JustinOng/bldctest2/README.md

PCB with STM32F103 + MP6540 to experiment with driving a small brushless gimbal motor

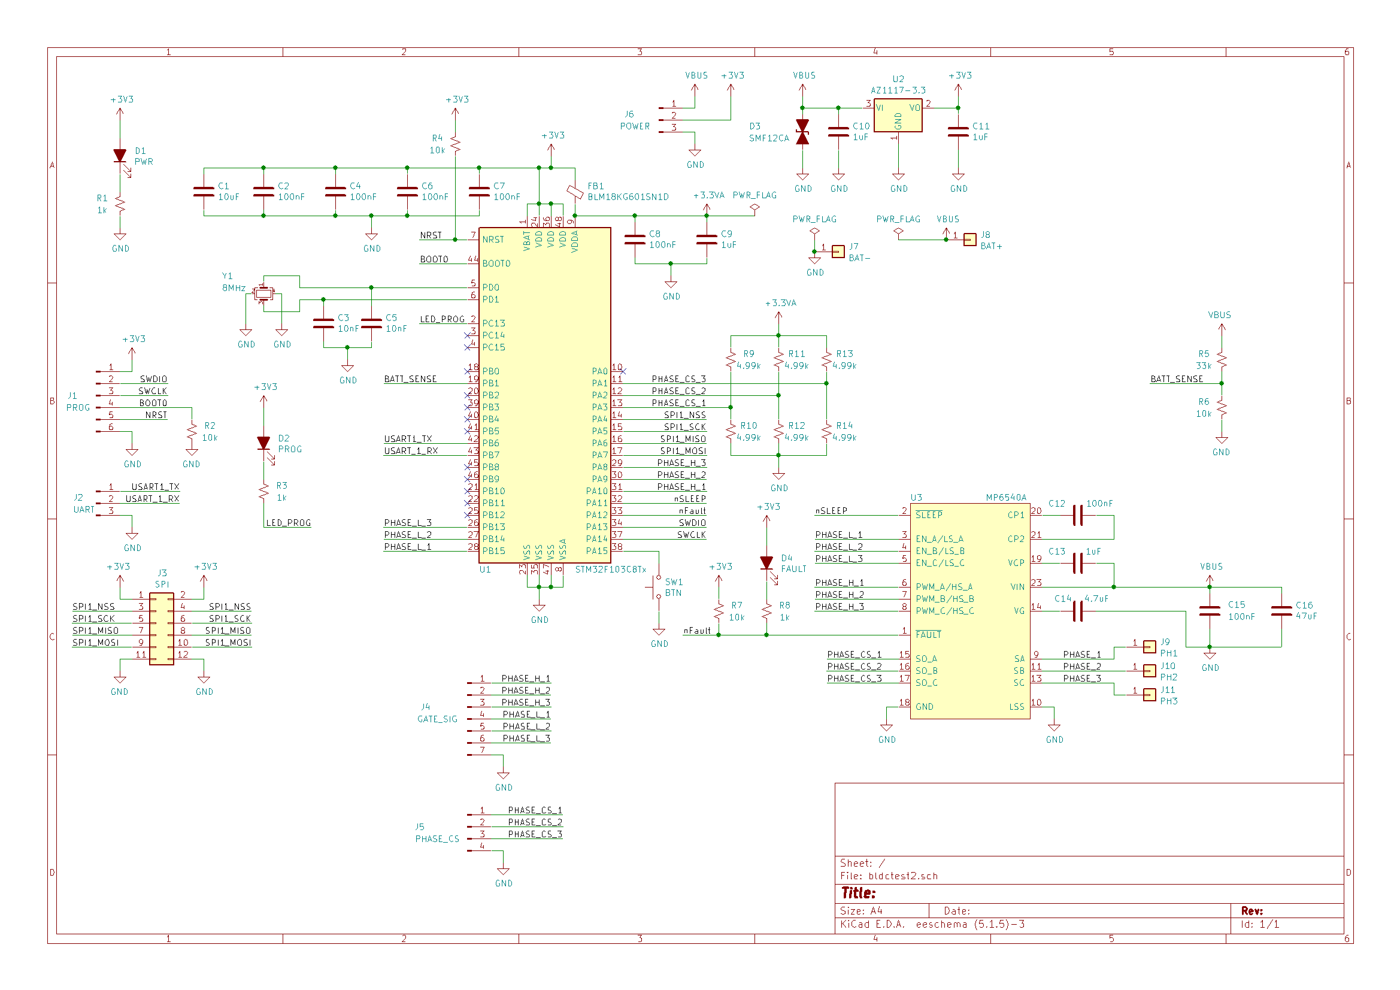
[picture p1: images/schematics.png]
Schematics

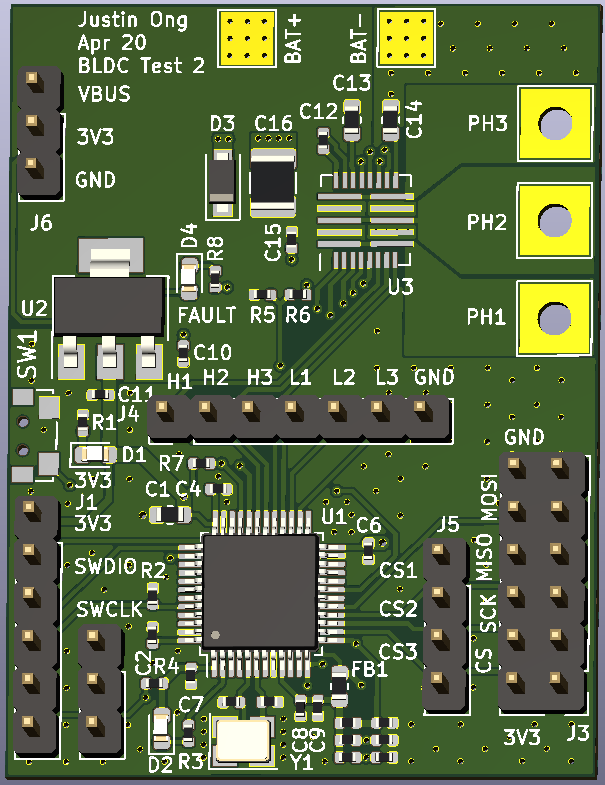
[picture p2: images/pcb_render.png]
PCB Render

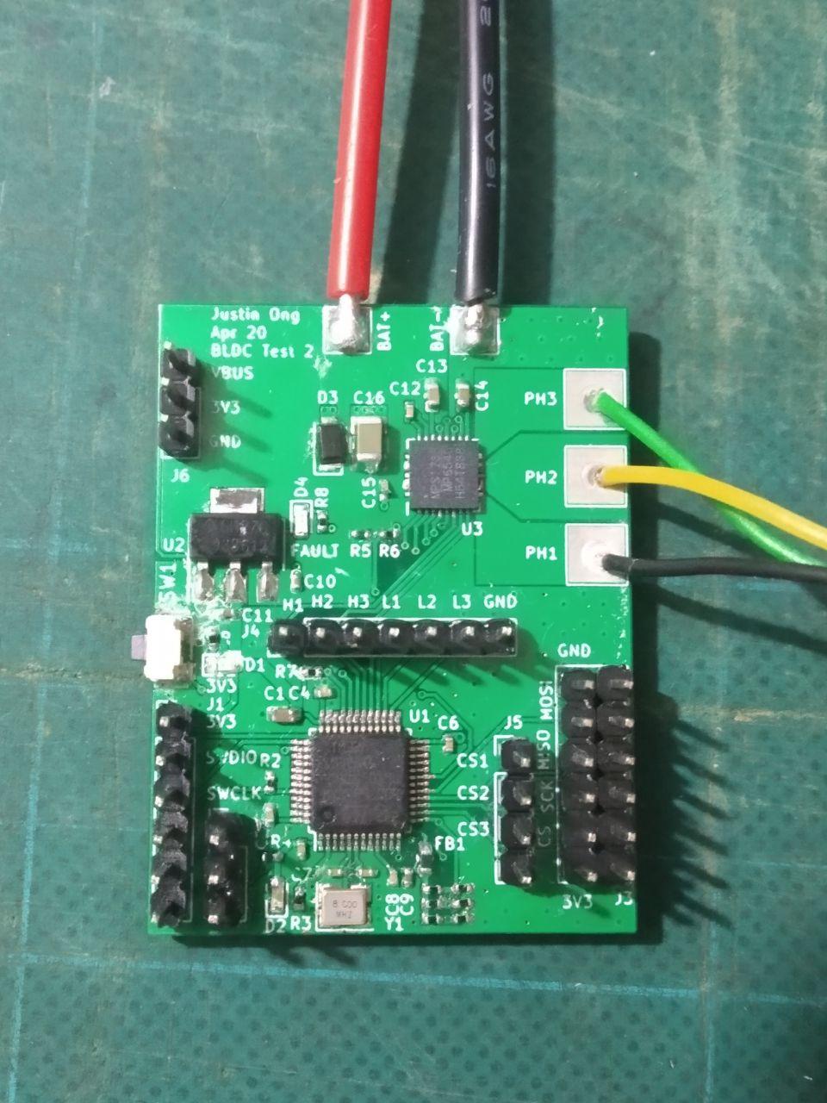
[picture p3: images/pcb_actual.jpg]
PCB Actual
