JustinOng/bldctest2/Hardware/bldctest2/bldctest2.kicad_pcb

## KiCad design Hardware/bldctest2/bldctest2.kicad_pcb (2020-05-05)

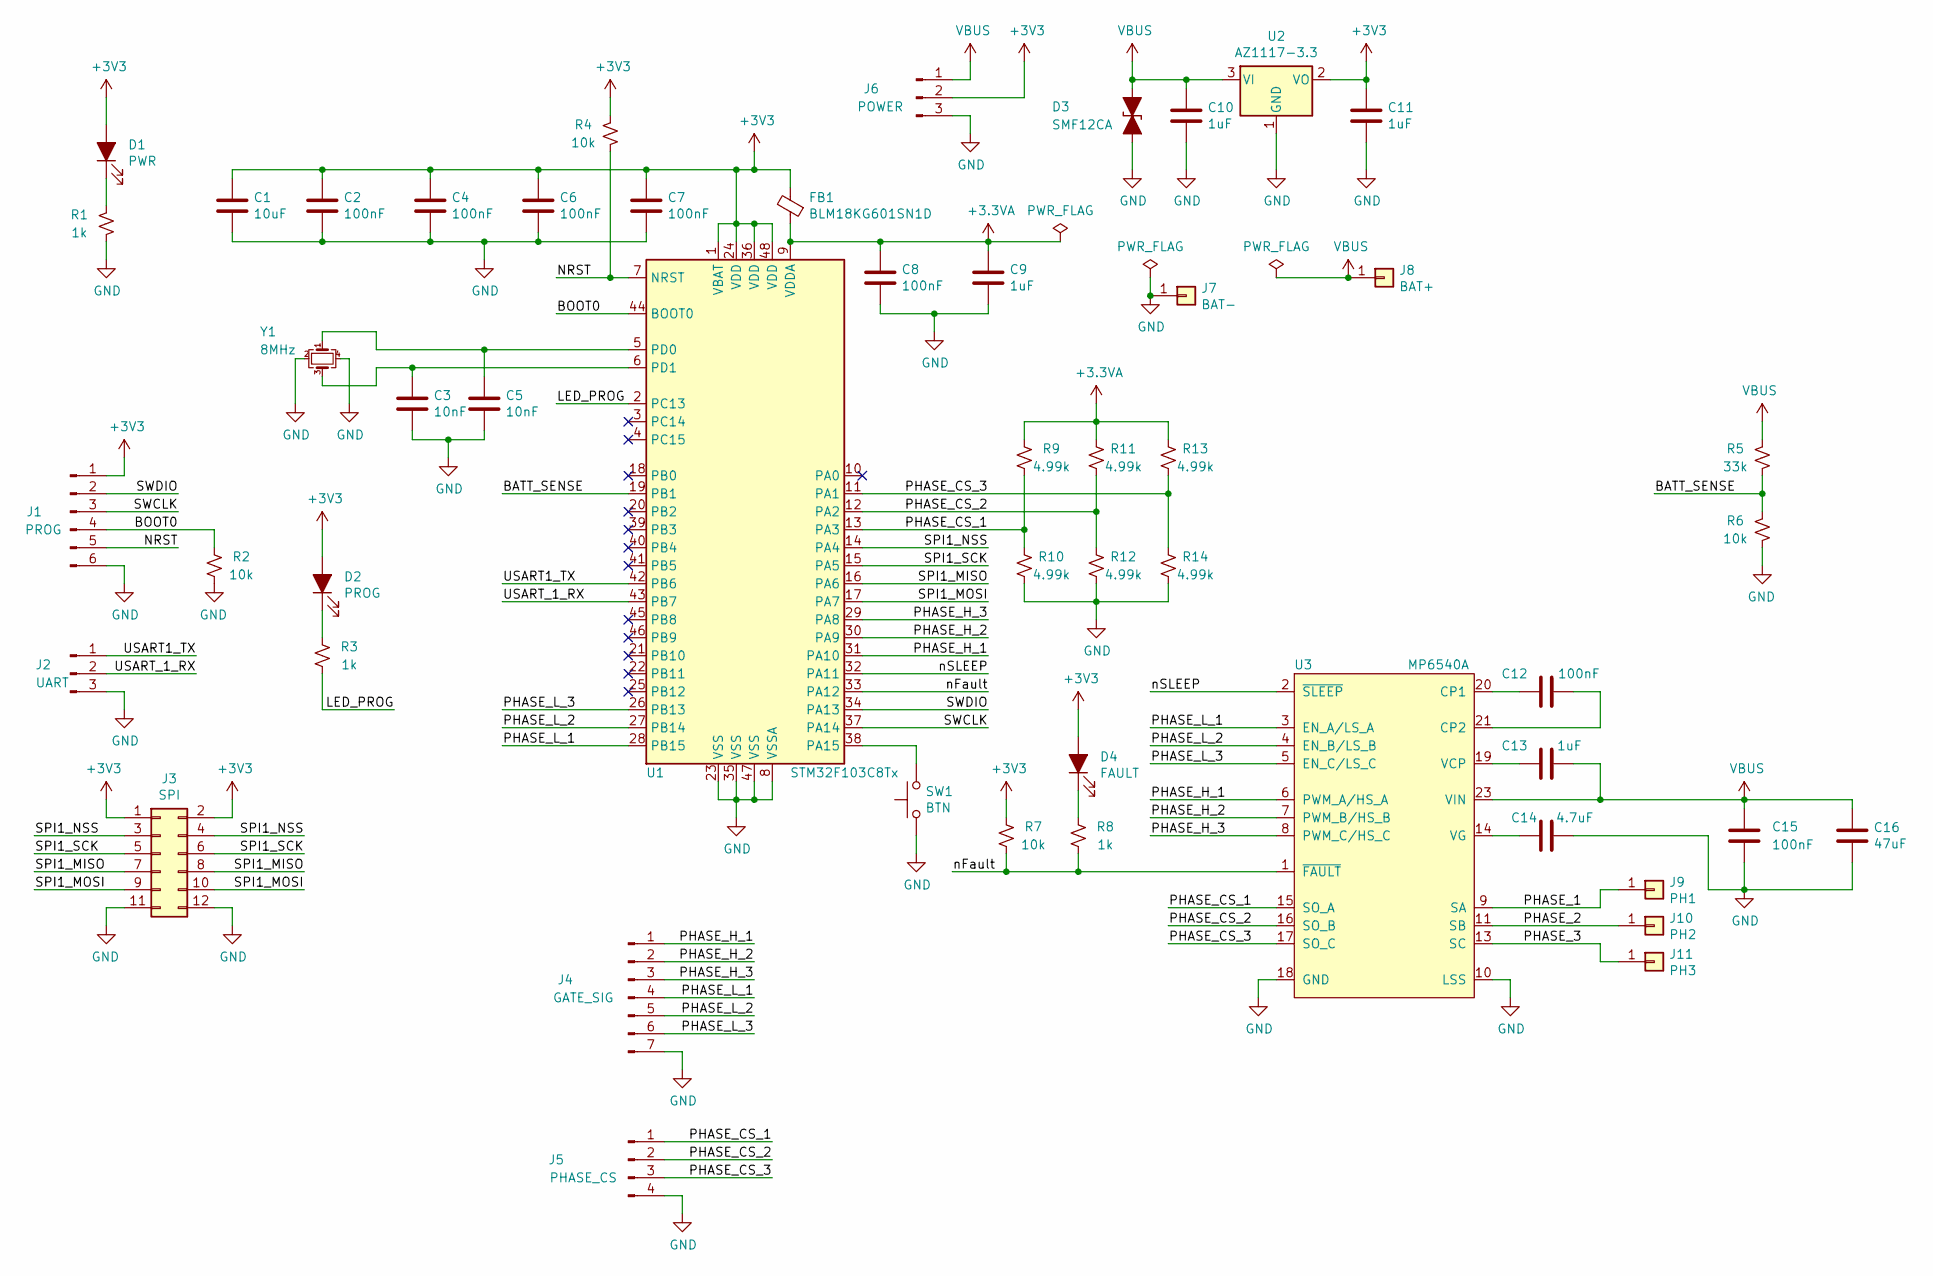
[picture p4: schematic bldctest2.sch]

Parts:
C1: 10uF; R_0603_1608Metric
C2, C4, C6, C7, C8, C12, C15: 100nF; R_0402_1005Metric; LCSC C41851
C3, C5: 10nF; R_0402_1005Metric; LCSC C1524
C9, C10, C11: 1uF; R_0402_1005Metric; LCSC C344046
C13: 1uF; R_0603_1608Metric
C14: 4.7uF; R_0603_1608Metric; LCSC C108342
C16: 47uF; R_1210_3225Metric; LCSC C385907
D1: PWR; LED_0603_1608Metric
D2: PROG; LED_0603_1608Metric
D3: SMF12CA; D_SOD-123F; LCSC C178259
D4: FAULT; LED_0603_1608Metric
FB1: BLM18KG601SN1D; R_0603_1608Metric
J1: PROG; PinHeader_1x06_P2.54mm_Vertical
J2: UART; PinHeader_1x03_P2.54mm_Vertical
J3: SPI; PinHeader_2x06_P2.54mm_Vertical
J4: GATE_SIG; PinHeader_1x07_P2.54mm_Vertical
J5: PHASE_CS; PinHeader_1x04_P2.54mm_Vertical
J6: POWER; PinHeader_1x03_P2.54mm_Vertical
J7: BAT-; TestPoint_Pad_3.0x3.0mm
J8: BAT+; TestPoint_Pad_3.0x3.0mm
J9: PH1; TestPoint_THTPad_4.0x4.0mm_Drill2.0mm
J10: PH2; TestPoint_THTPad_4.0x4.0mm_Drill2.0mm
J11: PH3; TestPoint_THTPad_4.0x4.0mm_Drill2.0mm
R1, R3, R8: 1k; R_0402_1005Metric; LCSC C226166
R2, R4, R6, R7: 10k; R_0402_1005Metric; LCSC C140214
R5: 33k; R_0402_1005Metric; LCSC C25779
R9, R10, R11, R12, R13, R14: 4.99k; R_0402_1005Metric; LCSC C140155
SW1: BTN; TS24CA; LCSC C393942
U1: STM32F103C8Tx; LQFP-48_7x7mm_P0.5mm; LCSC C8734
U2: AZ1117-3.3; SOT-223; LCSC C108494
U3: MP6540A; QFN-26_5x5_Pitch0.5mm
Y1: 8MHz; Crystal_SMD_3225-4Pin_3.2x2.5mm; LCSC C400090

Connections:
+3.3VA: C8.2, C9.2, FB1.1, R9.1, R11.1, R13.1, U1.9 (VDDA)
+3V3: C1.2, C2.2, C4.2, C6.2, C7.2, C11.2, D1.2 (A), D2.2 (A), D4.2 (A), FB1.2, J1.1, J3.1, J3.2, J6.2, R4.1, R7.1, U1.1 (VBAT), U1.24 (VDD), U1.36 (VDD), U1.48 (VDD), U2.2 (VO)
/BATT_SENSE: R5.2, R6.1, U1.19 (PB1)
/BOOT0: J1.4, R2.1, U1.44 (BOOT0)
/LED_PROG: R3.2, U1.2 (PC13)
/NRST: J1.5, R4.2, U1.7 (NRST)
/PHASE_1: J9.1, U3.9 (SA), U3.26 (SA)
/PHASE_2: J10.1, U3.11 (SB), U3.24 (SB)
/PHASE_3: J11.1, U3.13 (SC), U3.22 (SC)
/PHASE_CS_1: J5.1, R9.2, R10.1, U1.13 (PA3), U3.15 (SO_A)
/PHASE_CS_2: J5.2, R11.2, R12.1, U1.12 (PA2), U3.16 (SO_B)
/PHASE_CS_3: J5.3, R13.2, R14.1, U1.11 (PA1), U3.17 (SO_C)
/PHASE_H_1: J4.1, U1.31 (PA10), U3.6 (PWM_A/HS_A)
/PHASE_H_2: J4.2, U1.30 (PA9), U3.7 (PWM_B/HS_B)
/PHASE_H_3: J4.3, U1.29 (PA8), U3.8 (PWM_C/HS_C)
/PHASE_L_1: J4.4, U1.28 (PB15), U3.3 (EN_A/LS_A)
/PHASE_L_2: J4.5, U1.27 (PB14), U3.4 (EN_B/LS_B)
/PHASE_L_3: J4.6, U1.26 (PB13), U3.5 (EN_C/LS_C)
/SPI1_MISO: J3.7, J3.8, U1.16 (PA6)
/SPI1_MOSI: J3.9, J3.10, U1.17 (PA7)
/SPI1_NSS: J3.3, J3.4, U1.14 (PA4)
/SPI1_SCK: J3.5, J3.6, U1.15 (PA5)
/SWCLK: J1.3, U1.37 (PA14)
/SWDIO: J1.2, U1.34 (PA13)
/USART1_TX: J2.1, U1.42 (PB6)
/USART_1_RX: J2.2, U1.43 (PB7)
/nFault: R7.2, R8.2, U1.33 (PA12), U3.1 (~FAULT)
/nSLEEP: U1.32 (PA11), U3.2 (~SLEEP)
GND: C1.1, C2.1, C3.1, C4.1, C5.1, C6.1, C7.1, C8.1, C9.1, C10.1, C11.1, C14.2, C15.1, C16.1, D3.2 (A2), J1.6, J2.3, J3.11, J3.12, J4.7, J5.4, J6.3, J7.1, R1.2, R2.2, R6.2, R10.2, R12.2, R14.2, SW1.2, U1.8 (VSSA), U1.23 (VSS), U1.35 (VSS), U1.47 (VSS), U2.1 (GND), U3.10 (LSS), U3.12 (LSS), U3.18 (GND), Y1.2, Y1.4
unnamed: C3.2, U1.6 (PD1), Y1.3
unnamed: C5.2, U1.5 (PD0), Y1.1
unnamed: C12.1, U3.21 (CP2)
unnamed: C12.2, U3.20 (CP1)
unnamed: C13.2, U3.19 (VCP)
unnamed: C14.1, U3.14 (VG)
unnamed: D1.1 (K), R1.1
unnamed: D2.1 (K), R3.1
unnamed: D4.1 (K), R8.1
unnamed: SW1.1, U1.38 (PA15)
VBUS: C10.2, C13.1, C15.2, C16.2, D3.1 (A1), J6.1, J8.1, R5.1, U2.3 (VI), U3.23 (VIN), U3.25 (VIN)

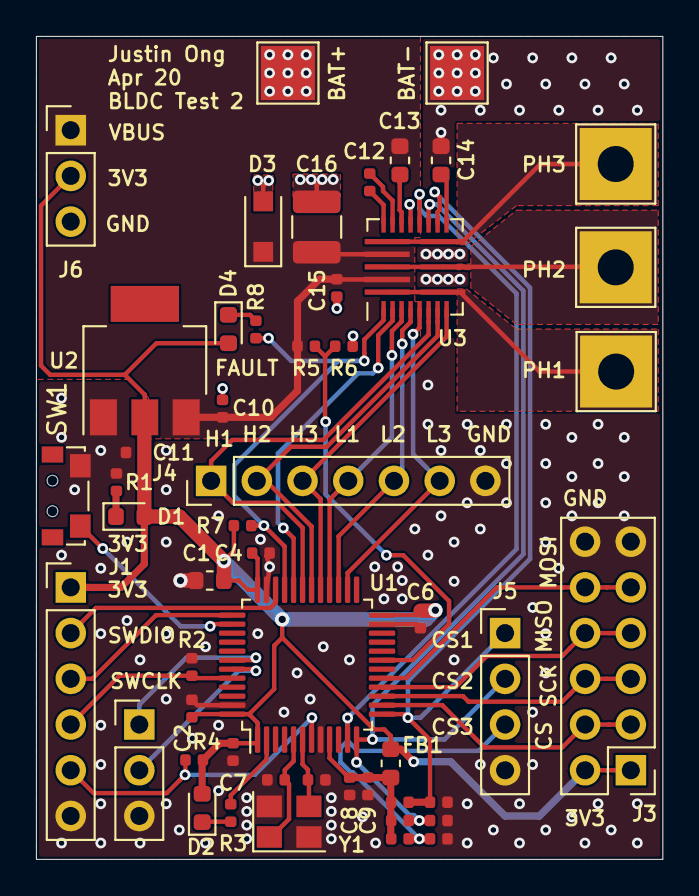
[picture p5: board bldctest2.kicad_pcb from above]

Board: 2 copper layers, 34.8 x 45.7 mm, 51 parts (0 on the bottom side), 40 nets.
