JustinOng/bldctest2/Software/bldctest2/bldctest2.ioc

Mcu.UserName=STM32F103C8Tx
PA1.GPIO_Label=PHASE_CS_3
PA1.Signal=ADCx_IN1
PA10.GPIO_Label=PHASE_PWM_1
PA10.Signal=S_TIM1_CH3
PA11.GPIO_Label=nSLEEP
PA11.Signal=GPIO_Output
PA12.GPIO_Label=nFault
PA12.Signal=GPIO_Input
PA13.Signal=SYS_JTMS-SWDIO
PA14.Signal=SYS_JTCK-SWCLK
PA15.GPIO_Label=BTN
PA15.Signal=GPIO_Input
PA2.GPIO_Label=PHASE_CS_2
PA2.Signal=ADCx_IN2
PA3.GPIO_Label=PHASE_CS_1
PA3.Signal=ADCx_IN3
PA4.GPIO_Label=SPI1_CS
PA4.Signal=GPIO_Output
PA5.Signal=SPI1_SCK
PA6.Signal=SPI1_MISO
PA7.Signal=SPI1_MOSI
PA8.GPIO_Label=PHASE_PWM_3
PA8.Signal=S_TIM1_CH1
PA9.GPIO_Label=PHASE_PWM_2
PA9.Signal=S_TIM1_CH2
PB1.GPIO_Label=BATT_SENSE
PB1.Signal=ADCx_IN9
PB13.GPIO_Label=PHASE_EN_3
PB13.Signal=GPIO_Output
PB14.GPIO_Label=PHASE_EN_2
PB14.Signal=GPIO_Output
PB15.GPIO_Label=PHASE_EN_1
PB15.Signal=GPIO_Output
PB6.Signal=USART1_TX
PB7.Signal=USART1_RX
PC13-TAMPER-RTC.GPIO_Label=LED
PC13-TAMPER-RTC.Signal=GPIO_Output
