JustinOng/bldctest2/Software/bldctest2/Core/Inc/main.h

#define LED_Pin GPIO_PIN_13
#define LED_GPIO_Port GPIOC
#define PHASE_CS_3_Pin GPIO_PIN_1
#define PHASE_CS_3_GPIO_Port GPIOA
#define PHASE_CS_2_Pin GPIO_PIN_2
#define PHASE_CS_2_GPIO_Port GPIOA
#define PHASE_CS_1_Pin GPIO_PIN_3
#define PHASE_CS_1_GPIO_Port GPIOA
#define SPI1_CS_Pin GPIO_PIN_4
#define SPI1_CS_GPIO_Port GPIOA
#define BATT_SENSE_Pin GPIO_PIN_1
#define BATT_SENSE_GPIO_Port GPIOB
#define PHASE_EN_3_Pin GPIO_PIN_13
#define PHASE_EN_3_GPIO_Port GPIOB
#define PHASE_EN_2_Pin GPIO_PIN_14
#define PHASE_EN_2_GPIO_Port GPIOB
#define PHASE_EN_1_Pin GPIO_PIN_15
#define PHASE_EN_1_GPIO_Port GPIOB
#define PHASE_PWM_3_Pin GPIO_PIN_8
#define PHASE_PWM_3_GPIO_Port GPIOA
#define PHASE_PWM_2_Pin GPIO_PIN_9
#define PHASE_PWM_2_GPIO_Port GPIOA
#define PHASE_PWM_1_Pin GPIO_PIN_10
#define PHASE_PWM_1_GPIO_Port GPIOA
#define nSLEEP_Pin GPIO_PIN_11
#define nSLEEP_GPIO_Port GPIOA
#define nFault_Pin GPIO_PIN_12
#define nFault_GPIO_Port GPIOA
#define BTN_Pin GPIO_PIN_15
#define BTN_GPIO_Port GPIOA
