JustinOng/bldctest2/Software/bldctest2/Core/Src/app/hardware.h

/*
 * hardware.h
 *
 *  Created on: May 1, 2020
 *      Author: Justin
 */

#ifndef SRC_APP_HARDWARE_H_
#define SRC_APP_HARDWARE_H_

#include "main.h"
#include "main.hpp"

void hardware_init(void);

#endif /* SRC_APP_HARDWARE_H_ */
