JustinOng/bldctest2/(commit log)

2020-05-05 Initial commit of hardware
    [bldctest2.kicad_pcb, bldctest2.sch]
2020-05-05 Set PWM to 32kHz, update loop at 8kHz
2020-05-06 Use ADC1 and ADC2 to sample phase current simultaneously
2020-05-06 Read position from AS5047P. Manually control CS because if controlled by the SPI peripheral, SCK seems to rise before CS, resulting in the encoder returning garbage.
2020-05-08 Use encoder as feedback to determine electrical angle
2020-05-09 Fix bug where the encoder wrap around could be missed when calibrating
    [motor.cpp]
2020-05-10 Implement closed loop control of velocity
